hoanglong2000tc/Audio_Amplifier/Report/Cover.tex

\begin{titlepage}
\begin{tikzpicture}[overlay,remember picture]
\draw [line width=3pt]
    ($ (current page.north west) + (3.0cm,-2.0cm) $)
    rectangle
    ($ (current page.south east) + (-2.0cm,2.5cm) $);
\draw [line width=0.5pt]
    ($ (current page.north west) + (3.1cm,-2.1cm) $)
    rectangle
    ($ (current page.south east) + (-2.1cm,2.6cm) $); 
\end{tikzpicture}
\begin{center}
\vspace{-12pt}  HANOI UNIVERSITY OF SCIENCE AND TECHNOLOGY \\
\textbf{\fontsize{13pt}{0pt}\selectfont SCHOOL OF ELECTRONICS AND TELECOMMUNICATION}
\vspace{0.5cm}
 \begin{figure}[H]
     \centering
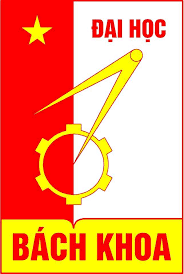
[picture p1: Report/figure/logodhbk.png]
     
 \end{figure}
\vspace{1.5cm}
\fontsize{24pt}{0pt}\selectfont FINAL PROJECT\\
\vspace{12pt}
\textbf{\fontsize{32pt}{0pt}\selectfont ELECTRONIC CIRCUIT I}
\vspace{1.5cm}
\end{center}
\hspace{6pt}\textbf{\fontsize{14pt}{0pt}\selectfont Topic:}
\begin{center}
    \textbf{\fontsize{20pt}{0pt}\selectfont AUDIO AMPLIFIER}\\

\vspace{1.5cm}
\begin{table}[H]
    \centering
    \begin{tabular}{l l}
 \fontsize{14pt}{0pt}\selectfont Student:    & \fontsize{14pt}{0pt}\selectfont VU HOANG LONG - 20182926 \vspace{6pt} \\ 
     &\fontsize{14pt}{0pt}\selectfont class CTTT Dien tu 01 - K63 \vspace{6pt}\\
\fontsize{14pt}{0pt}\selectfont Instructor: & \fontsize{14pt}{0pt}\selectfont DR. NGUYEN VU THANG
\end{tabular}
\end{table}
\vspace{3.5cm}
 \fontsize{14pt}{0pt}\selectfont Hanoi, \today
\end{center}
\end{titlepage}
\cleardoublepage
