hoanglong2000tc/Audio_Amplifier/Report/cover.docx

TRƯỜNG ĐẠI HỌC BÁCH KHOA HÀ NỘI

VIỆN ĐIỆN TỬ - VIỄN THÔNG

logo_128

FINAL PROJECT

ELECTRONIC CIRCUIT I

Topic: Audio Amplifier

Student: VU HOANG LONG

Student ID: 20182926

Instructor: Dr. NGUYEN VU THANG

Hà Nội, 5-2019
