hoanglong2000tc/Audio_Amplifier/Report/figure/cover.png

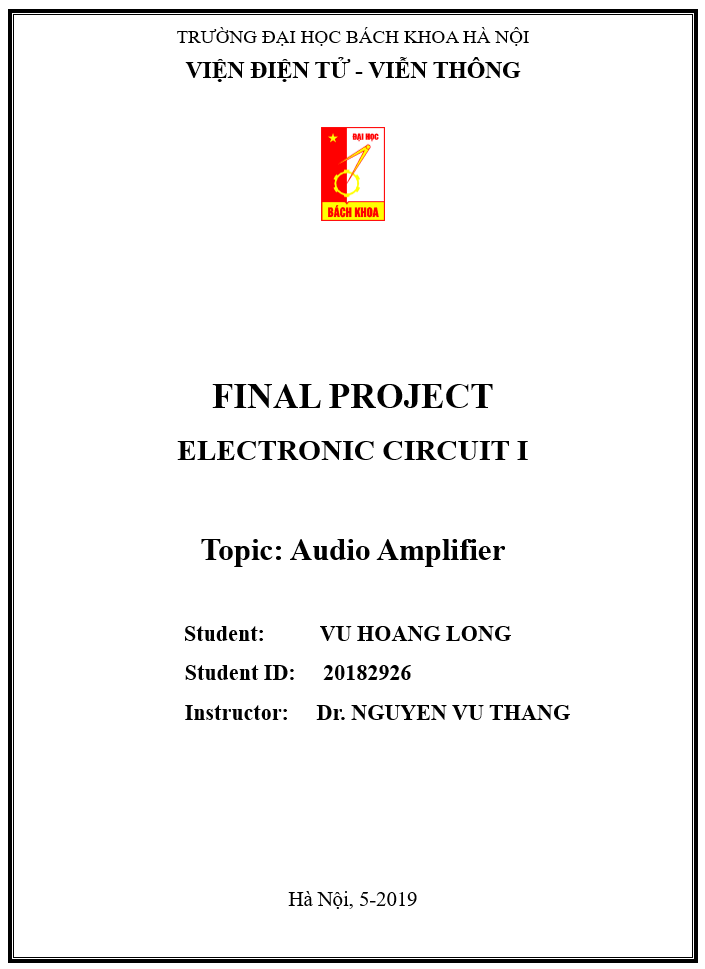
Report/figure/cover.png
