hoanglong2000tc/Audio_Amplifier/resistance_value.jpg

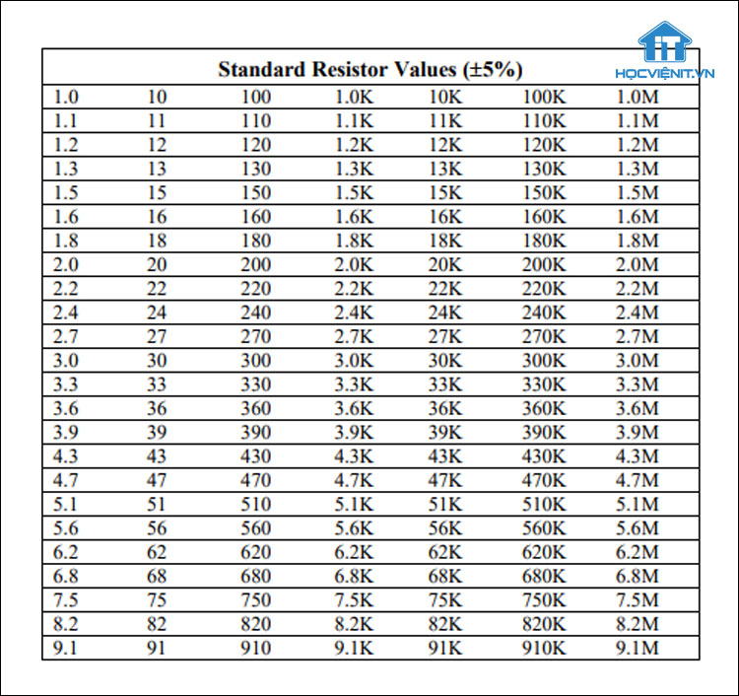
resistance_value.jpg
