hoanglong2000tc/Audio_Amplifier/Schem_to_PDF/schematic.pdf

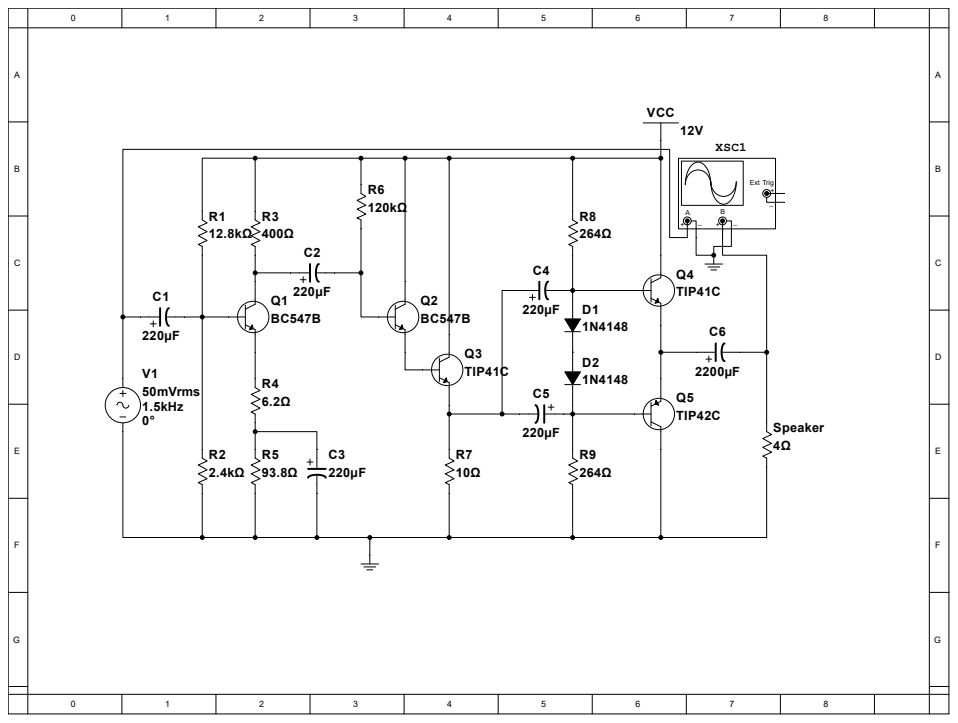
[picture p20: page 1]
