hoanglong2000tc/Audio_Amplifier/hóa đơn.pdf

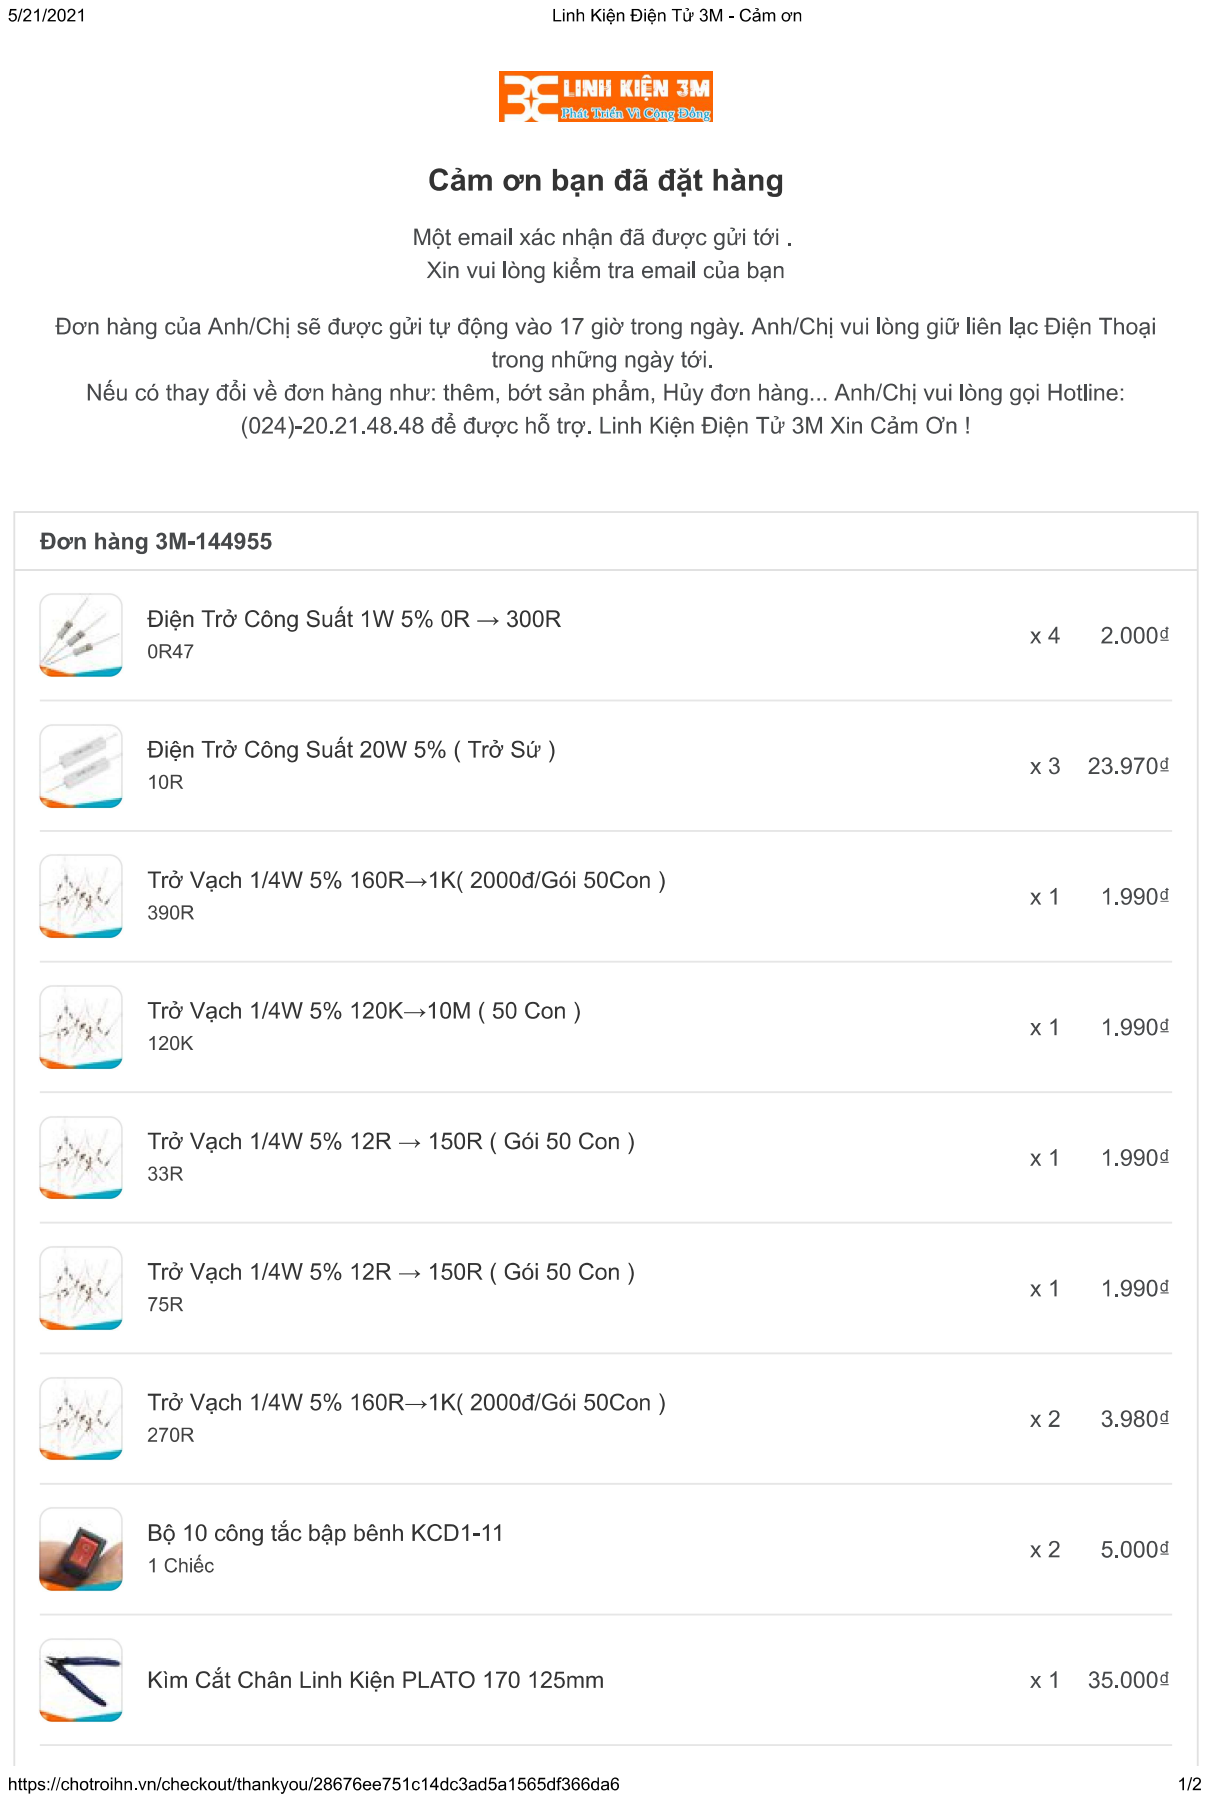
[picture p21: page 1]

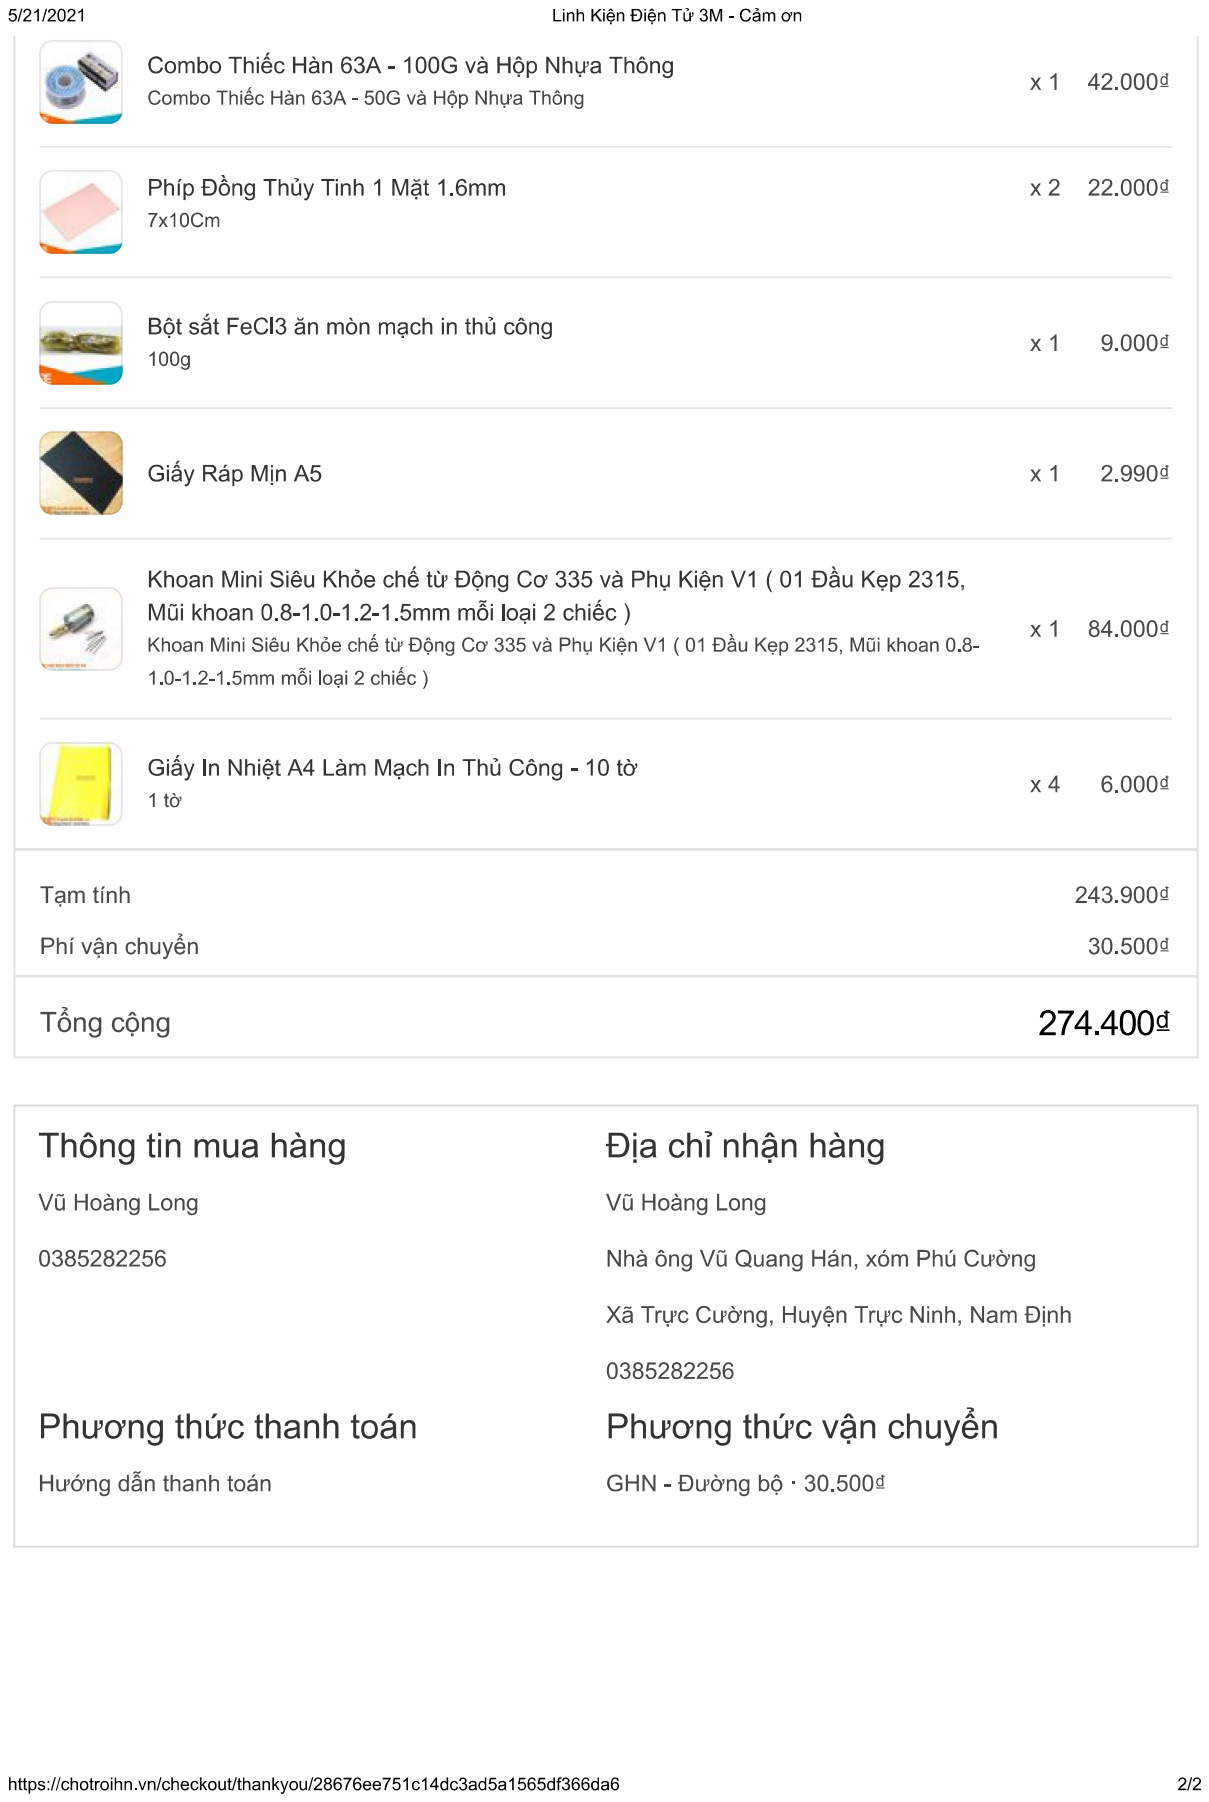
[picture p22: page 2]
