hoanglong2000tc/Audio_Amplifier/PCB.pdf

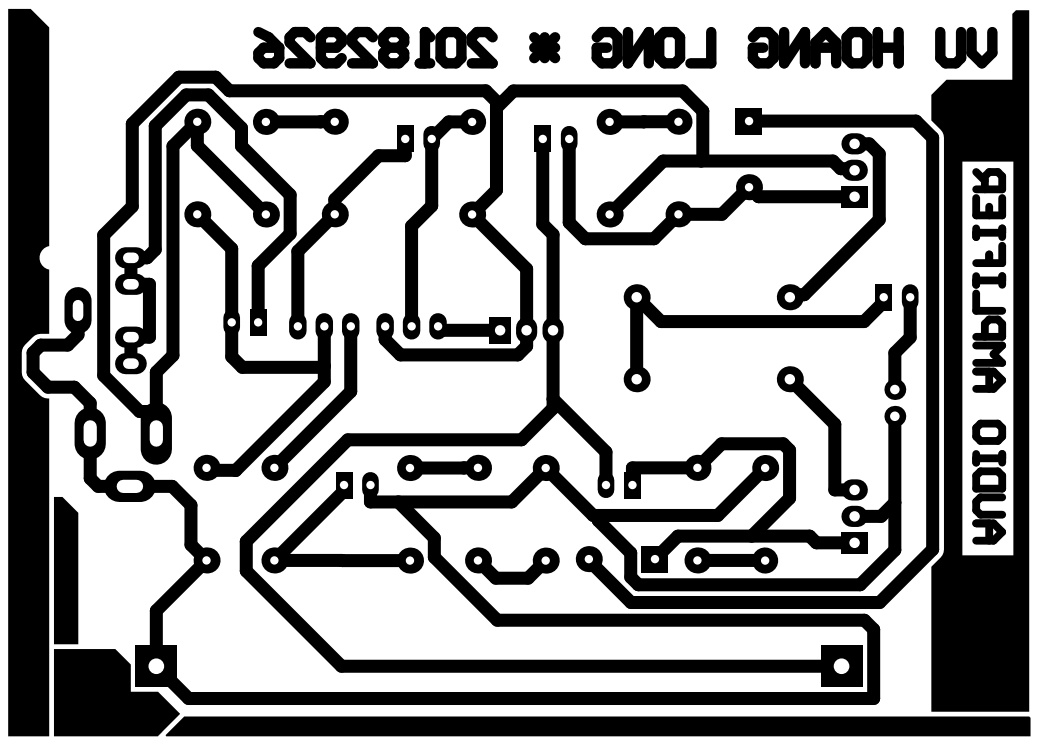
[picture p23: page 1]
