hoanglong2000tc/Audio_Amplifier/Schem_to_PDF/Schem_to_PCB.pdf

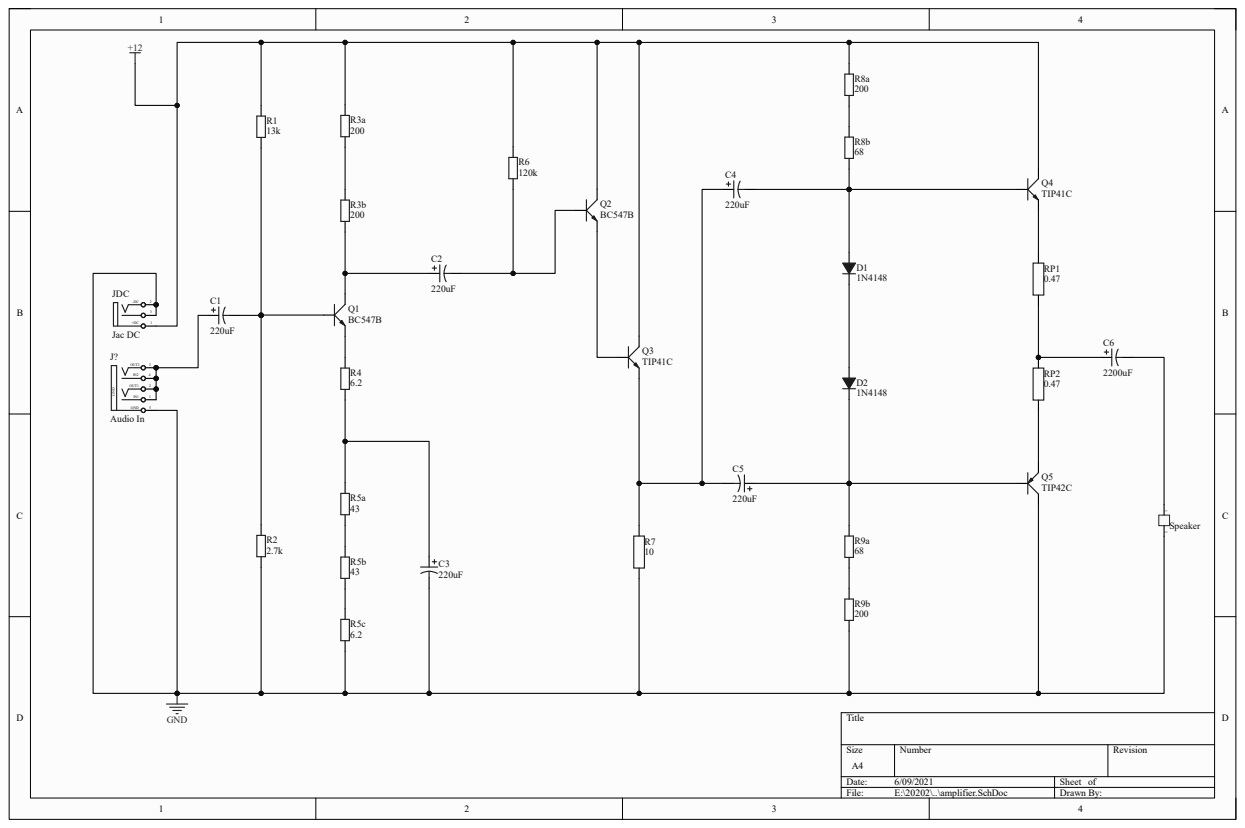
[picture p24: page 1]
