hoanglong2000tc/Audio_Amplifier/Schem_to_PDF/stage_1.pdf

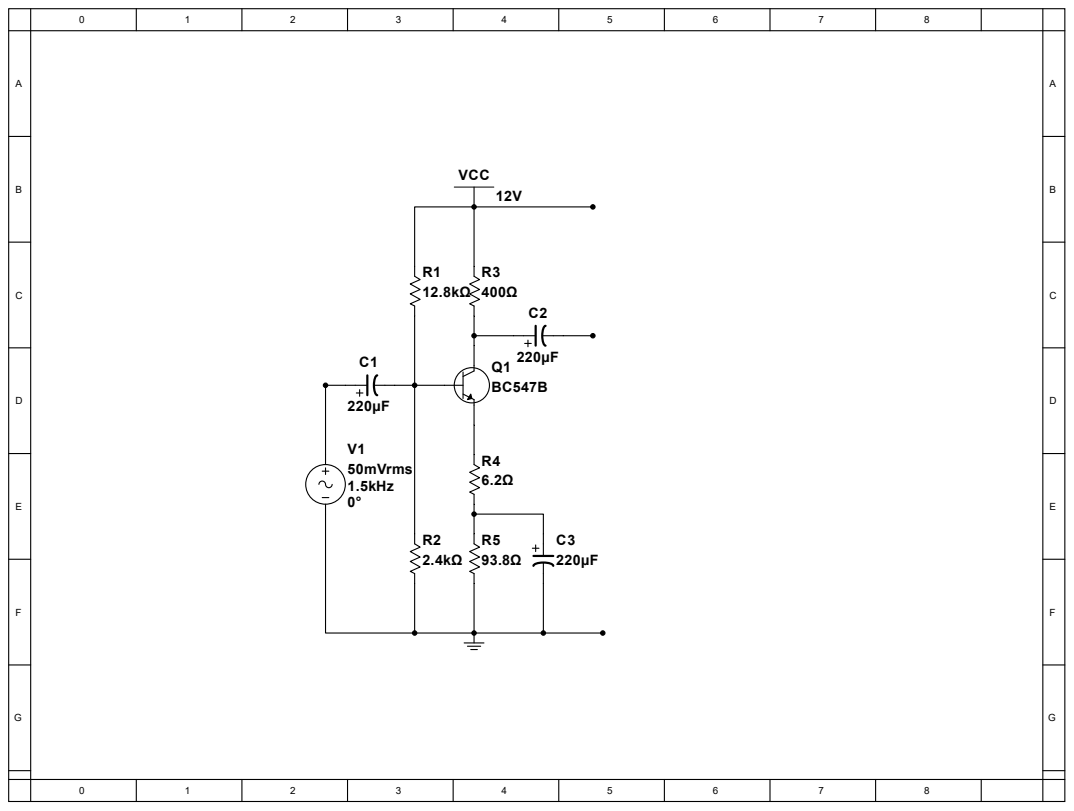
[picture p25: page 1]
