hoanglong2000tc/Audio_Amplifier/Schem_to_PDF/Stage_2.pdf

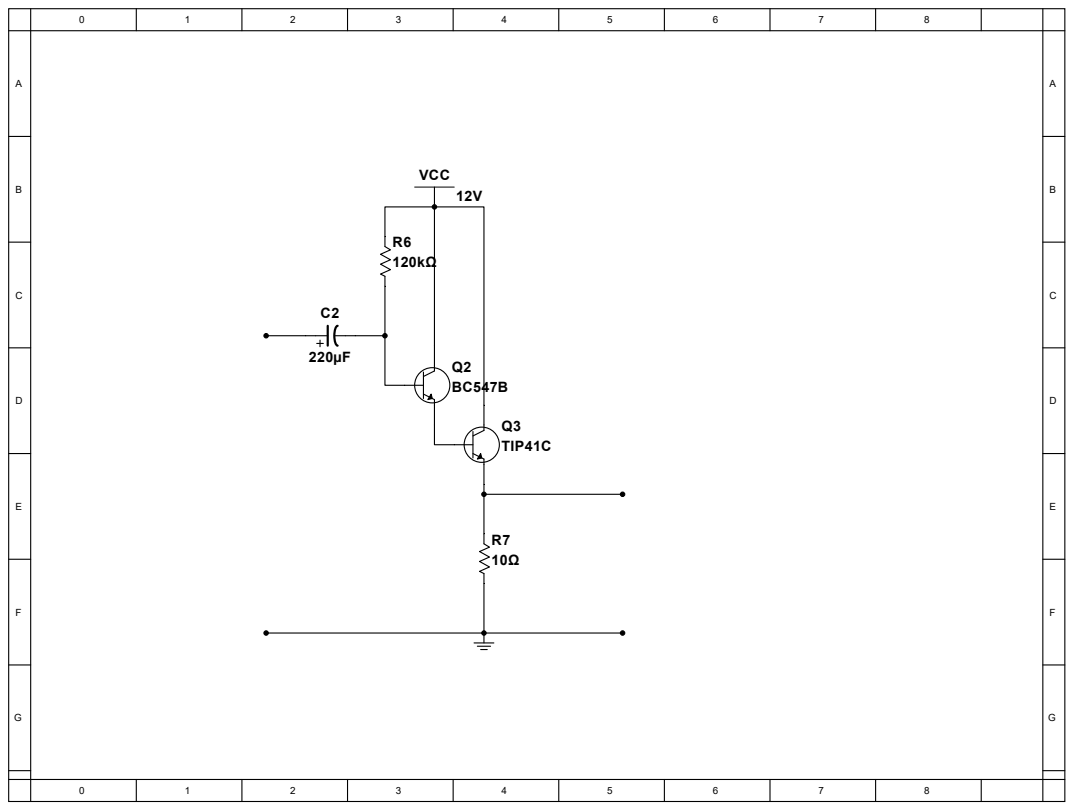
[picture p26: page 1]
VCC; Q3 TIP41C
