hoanglong2000tc/Audio_Amplifier/Schem_to_PDF/Stage_3.pdf

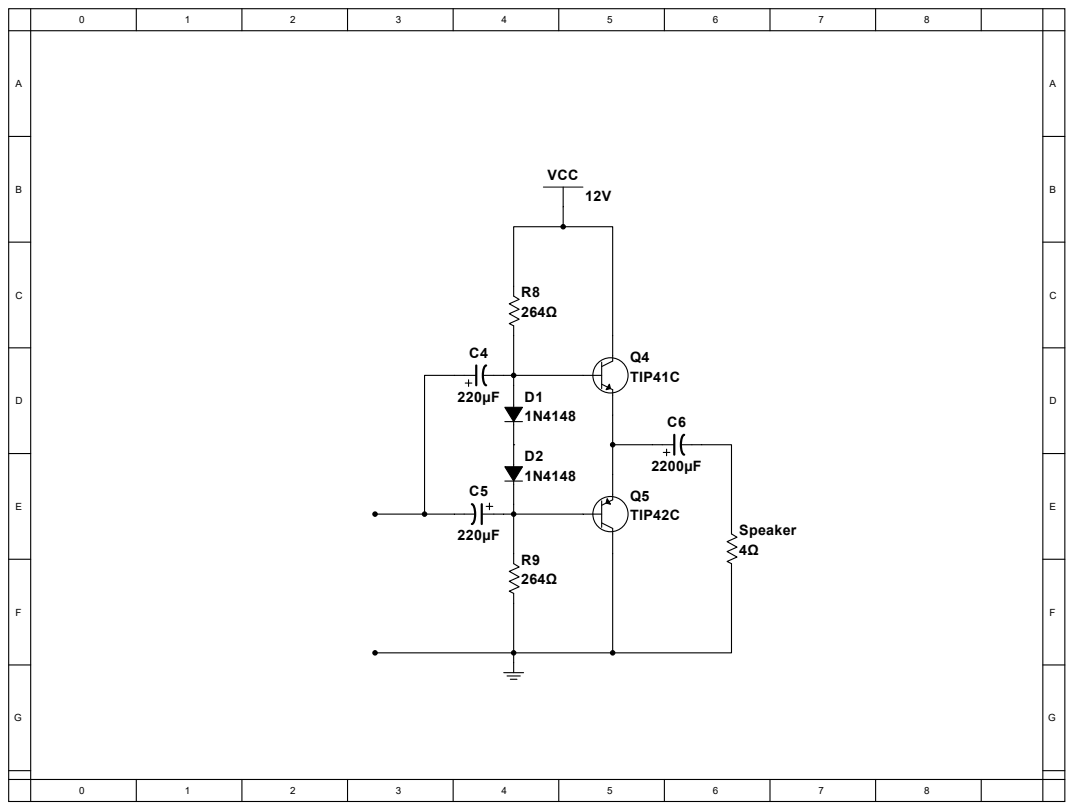
[picture p27: page 1]
