hoanglong2000tc/Audio_Amplifier/(list of files, drawings)

Other design files:
Altium/amplifier/amplifier.PcbDoc
Altium/amplifier/amplifier.PrjPcb
Altium/amplifier/amplifier.SchDoc
Schematic/Design1.ms14
Schematic/Design2.ms14
Schematic/divide.ms14
Schematic/offical.ms14
Schematic/Schematic.pdsprj
Schematic/toPCB.ms14
